fairyang/Course-design-of-mechanical-design/README.md

# Course-design-of-mechanical-design
## 本科机械设计课设
### 带式运输机传动装置设计
参数：F=1300_v=1.55_D=250
(V带-一级斜齿圆柱-联轴器)(高上低下)
#### 如果对你有帮助，记得给个star
