fairyang/Course-design-of-mechanical-design/(list of files, cad)

Other CAD files:
装配图（A0）（1：1）.dwg
大齿轮（A3）（1：1.5）.dwg
低速轴（A3）（1：1）.dwg
